rmeissn/esp-kwb-mqtt-ha-logger-/pictures/PXL_20201004_154122790.jpg

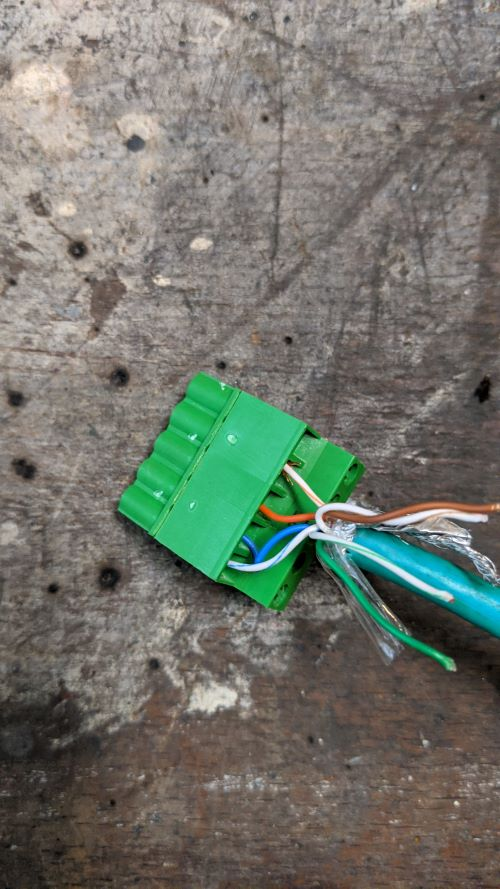
pictures/PXL_20201004_154122790.jpg
