rmeissn/esp-kwb-mqtt-ha-logger-/pictures/PXL_20201004_155612305.jpg

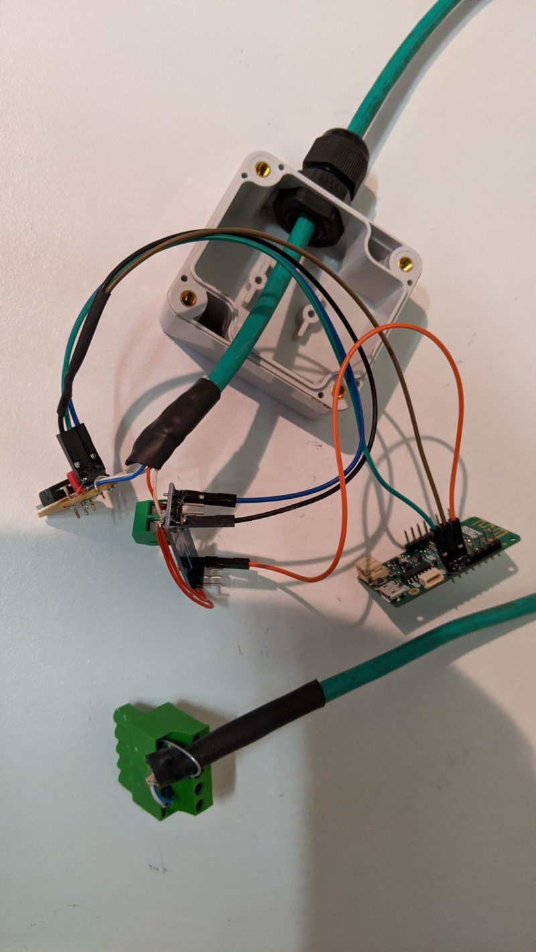
pictures/PXL_20201004_155612305.jpg
