rmeissn/esp-kwb-mqtt-ha-logger-/pictures/PXL_20201004_155644567.jpg

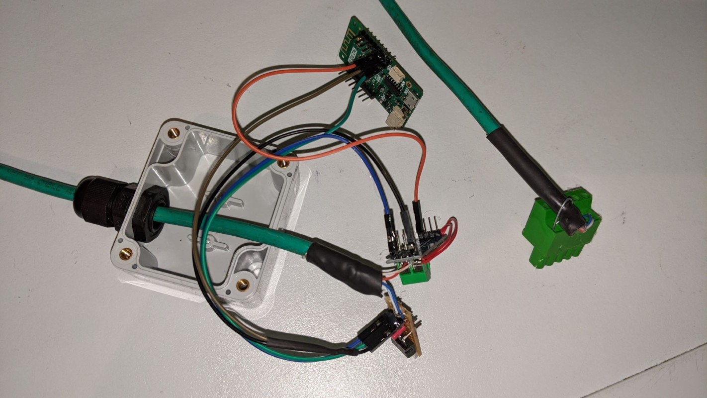
pictures/PXL_20201004_155644567.jpg
