rmeissn/esp-kwb-mqtt-ha-logger-/pictures/PXL_20201004_155710227.jpg

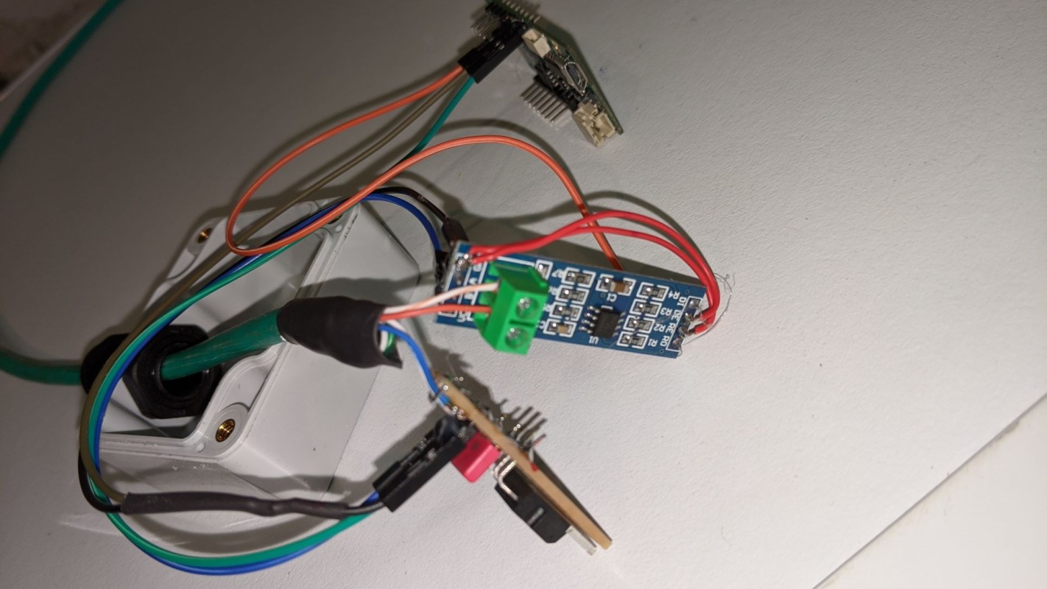
pictures/PXL_20201004_155710227.jpg
