rmeissn/esp-kwb-mqtt-ha-logger-/pictures/PXL_20201004_160445885.jpg

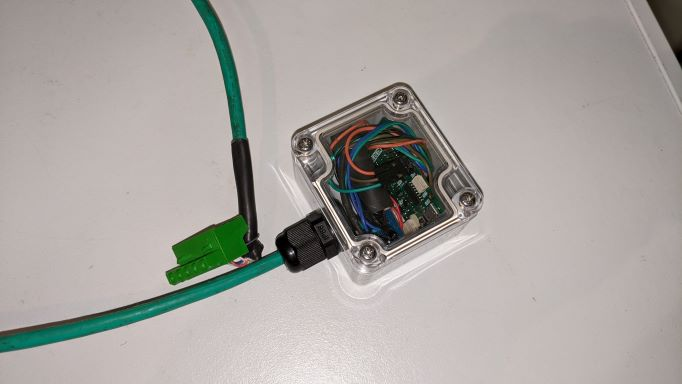
pictures/PXL_20201004_160445885.jpg
