rmeissn/esp-kwb-mqtt-ha-logger-/pictures/Schaltplan.png

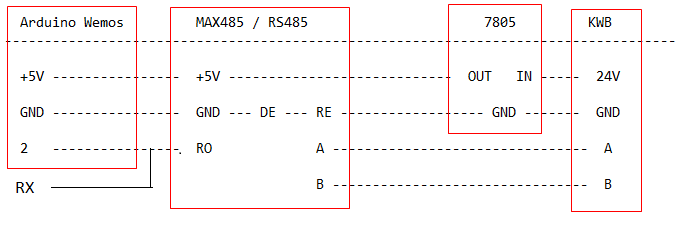
pictures/Schaltplan.png
