rmeissn/esp-kwb-mqtt-ha-logger-/(commit log)

2022-11-27 Added mqtt User Authentication MQTT Prefix kwb fixed crc calculation removed lots of commented out code added additional values
    [espinclude.h]
2023-01-08 Reworked photo diod code to match a range between 0 and 100
    [esp-kwb-mqtt-ha-logger-.ino]
2023-01-08 Fixed and improved code to report boiler status
    [esp-kwb-mqtt-ha-logger-.ino]
2023-01-08 Code Refactoring, introduced Saugzug, reworked Raumaustragung
    [esp-kwb-mqtt-ha-logger-.ino]
2023-01-09 Beautified code via Arduino IDE 2
2023-01-09 Added OTA code for Arduino IDE
2023-01-09 Corrected Readme, added comment about RLA valve
    [esp-kwb-mqtt-ha-logger-.ino]
2023-01-17 Refactoring - shortened sensor config
    [esp-kwb-mqtt-ha-logger-.ino]
2023-01-19 Fixed some states were not changing & optimized function argument copy behaviour
    [esp-kwb-mqtt-ha-logger-.ino]
2023-01-20 Replaced double with float (should be sufficient and calculations are faster on esp8266)
    [esp-kwb-mqtt-ha-logger-.ino, espinclude.h]
2023-01-28 Added RLA valve position calculation and state publishing
2023-01-29 Added power approximation of boiler in %
